CodingIndeed/XIAO-ESP32S3-HAT-module/Hardware/BOM_IMU_Barometer_SDIO_PCB_IMU_Baro_SDIO_2025-05-21.xlsx

No. | Quantity | Comment | Designator | Footprint | Value | Manufacturer Part | Manufacturer | Supplier Part | Supplier | Primary Category | Secondary Category | Pin Count | Layer | Mounting Style | Description | Unique Id | spicePre | link | Unique ID | Name | Device | Convert to PCB | Add into BOM
1 | 4 | 0.1u | C1,C4,C5,C8 | C0603 |  |  |  |  |  |  |  | 2 | T |  |  | gge09a8a2a49580c9d5,gge90a8ee926d718260,gge942ddf6ba3709c91,ggefa86acd540f45489 | C |  | $9,$15,$16,$17 | 0.1u | 0.1u |  | yes
2 | 2 | 22p | C2,C3 | C0603 |  |  |  |  |  |  |  | 2 | T |  |  | gge4173eb936568cc30,gged97166dcc85f16f2 | C |  | $4,$5 | 22p | 10u,22p |  | yes
3 | 1 | 0.1u | C6 | C0603 |  |  |  |  |  |  |  | 2 | B |  |  | gge9d3fab93552bbddc | C |  | $6 | 0.1u | 0.1u |  | yes
4 | 1 | 10u | C7 | C0603 |  |  |  |  |  |  |  | 2 | B |  |  | gge5de91cdc91667709 | C |  | $7 | 10u | 10u |  | yes
5 | 1 | LED-0603_G | LED1 | LED0603_GREEN |  | 19-217/GHC-YR1S2/3T | EVERLIGHT(台湾亿光) | C72043 | LCSC |  |  | 2 | B |  |  | gge856c1967296df4d8 | L |  | $2 | LED-0603_G | LED-0603_G |  | yes
6 | 3 | 10k | R4,R7,R8 | R0603 |  |  |  |  |  |  |  | 2 | T |  |  | gge5b3a81ea565e60c8,ggeb08e373d62c2637c,ggeff5f2a10ab9ab37f | R |  | $10,$12,$18 | 10k | 10k |  | yes
7 | 1 | 1k | R5 | R0603 |  |  |  |  |  |  |  | 2 | T |  |  | gge84a74d418b485718 | R |  | $11 | 1k | 1k |  | yes
8 | 1 | 4.7kΩ | RN1 | RES-ARRAY-SMD_0603-16P-L6.4-W1.6-TL |  | CAT16-472J8LF | BOURNS | C1518176 | LCSC |  |  | 16 | B |  |  | ggeadf6c0f6fda94ecb | R |  | $8 | 4.7kΩ | 4.7kΩ |  | yes
9 | 1 | 4.7kΩ | RN3 | RES-ARRAY-SMD_0603-4P-L1.6-W1.6-BL |  | YC162-JR-074K7L | YAGEO(国巨) | C326936 | LCSC |  |  | 4 | T |  |  | ggea4a33a82ef0f6360 | R |  | $19 | 4.7kΩ | 10kΩ |  | yes
10 | 2 | 10kΩ | RN4,RN5 | RES-ARRAY-SMD_0603-4P-L1.6-W1.6-BL |  | YC162-JR-0710KL | YAGEO(国巨) | C309680 | LCSC |  |  | 4 | T |  |  | gge475313dc62069b4d,ggea19e8d5f1d926d5a | R |  | $20,$21 | 10kΩ | 10kΩ |  | yes
11 | 1 | BMP581 | U1 | LGA-10_L2.0-W2.0-P0.50-TL_BMP581 |  | BMP581 | Bosch(博世) | C5362283 | LCSC |  |  | 10 | T |  |  | ggefda8a8847f6f7d8b | U |  | $13 | BMP581 | BMP581 |  | yes
12 | 1 | BNO086 | U2 | LGA-28_L5.2-W3.8-P0.50-BL |  | BNO086 | null | C5264422 | LCSC |  |  | 28 | T |  |  | gge0879c493cfee3464 | U |  | $22 | BNO086 | BNO086 |  | yes
13 | 2 | 2.2kΩ | U3,U4 | RES-ARRAY-SMD_0404-4P-L1.0-W1.0-BL |  | YC122-JR-072K2L | YAGEO(国巨) | C695193 | LCSC |  |  | 4 | T |  |  | gge01943228c9da44f1,ggef0a08ab114346478 | U |  | $14,$23 | 2.2kΩ | 2.2kΩ |  | yes
14 | 1 | MICROSD104031-0811 | X2 | MOLEX_104031-0811 |  |  |  |  |  |  |  | 14 | B |  |  | gge8956a4de66c75f84 | X |  | $1 | MICROSD104031-0811 | MICROSD104031-0811 |  | yes
15 | 1 | 32.768kHz | X3 | OSC-SMD_2P-L3.2-W1.5 |  | ABS07-32.768KHZ-T | ABRACON | C130253 | LCSC |  |  | 2 | T |  |  | gge200af03f1eb1f089 | X |  | $3 | 32.768kHz | 32.768kHz |  | yes
