CodingIndeed/XIAO-ESP32S3-HAT-module/Schematic.pdf

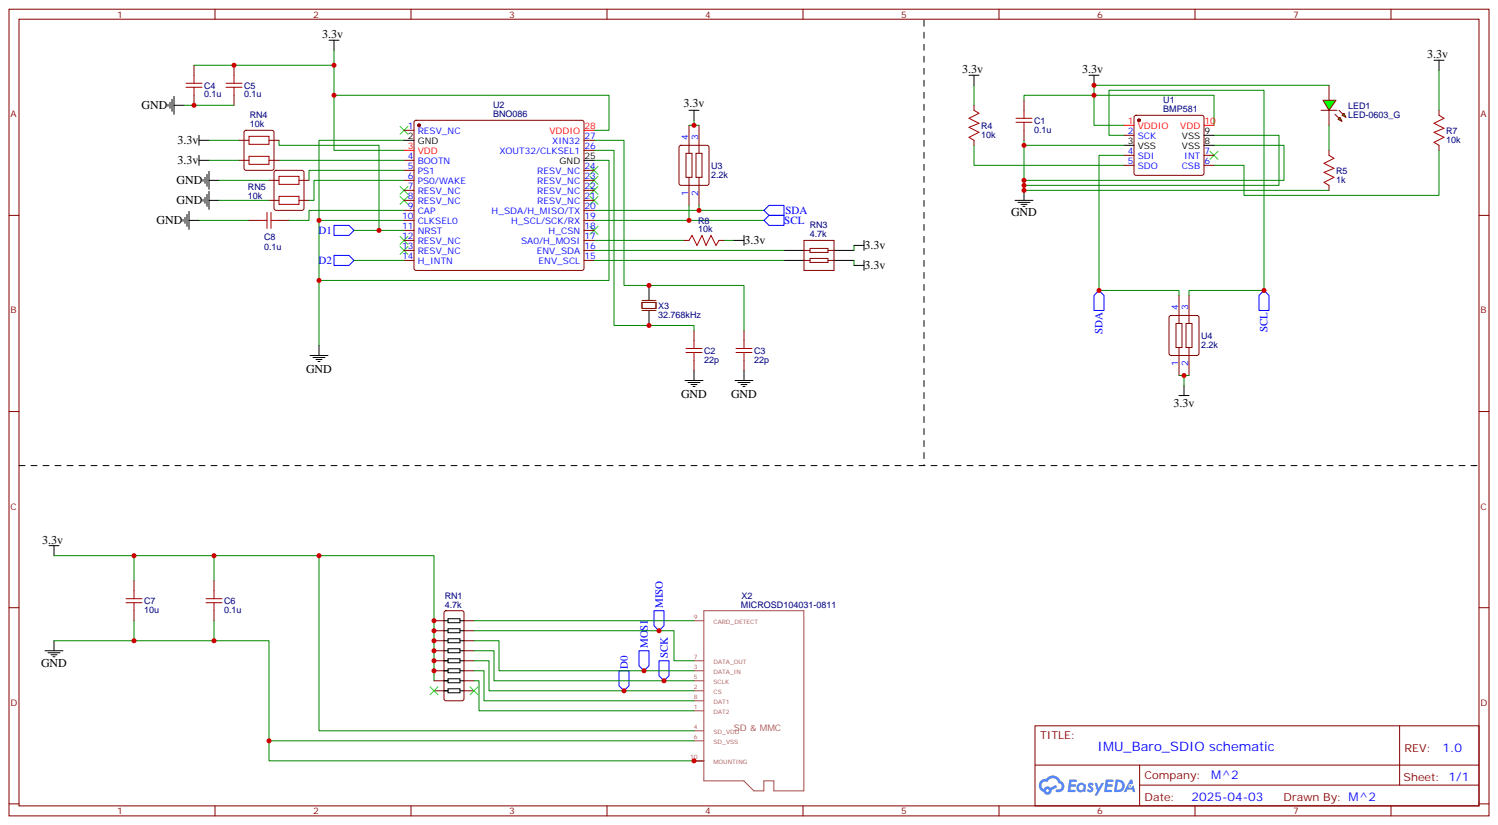
[picture p3: page 1]
